adamgreig/supervide/panels/hardware.md

# Hardware shopping list
## Power end-plate
* 4 x M3x8 screws
* 4 x M3 full nuts

## Power mounting plates
* 7 x M3x10 screws
* 1 x M3x12 screws
* 8 x M3 full nuts

## Control end-plate
* 4 x M3x10 M-F pillars
* 4 x M3x6 screws
* 4 x M3 plain washers
* 4 x M3 full nuts
