adamgreig/supervide/power/bom.ods

Sheet: References
REF | FARNELL | DESC
C1 | 1759226 | 1nF 0805
C2 | 1759166 | 100nF 0805
C3 | 1759166 | 100nF 0805
C4 | 2057310 | 22nF 1210 HV
D1 | 2099239 | Green LED 0805
D2 | 2099243 | Yellow LED 0805
D3 | 2099236 | Red LED 0805
D4 | 1685055 | Orange LED 0805
F1 | 1162740 | 5x20mm clip
F2 | 1603990 | 1/2 BS1362 clip
K1 | 2325624 | RZ03-1A4
P1 | 2215303 | 2x4 conn
P2 | 2080426 | mains inlet
P3 | 2080465 | mains outlet
P4 | - | TP
P5 | - | TP
P6 | - | TP
Q1 | 1081223 | BC817-40
Q2 | 1081223 | BC817-40
R1 | 2331790 | 390R 0805
R2 | 2138881 | 300R 0805
R3 | 2138881 | 300R 0805
R4 | 2331790 | 390R 0805
R5 | 2138881 | 300R 0805
R6 | 2331790 | 390R 0805
R7 | 2138881 | 300R 0805
R8 | 1887414 | 47R 1206 HV
R9 | 2331787 | 300R 0805
U1 | 2401030 | VTX214
U2 | 1791411 | ACS710
U3 | SN36219 | Thermal switch
U4 | 1467853 | MOC3163-M
U5 | 1057281 | BTA16-800BRG
- | 1703170 | Heatsink
- | PL09982 | 13A BS1363
- | FF02750 | 100mA 5x20mm

Sheet: Parts
REFS | FARNELL | DESC | QUANTITY PER | Q FOR 3 BOARDS | SPARES | OWNED | TO ORDER
C1 | 1759226 | 1nF 0805 | 1 | 3 | 7 | 0 | 10
C2,C3 | 1759166 | 100nF 0805 | 2 | 6 | 4 | 0 | 10
C4 | 2057310 | 22nF 1210 HV | 1 | 3 | 2 | 0 | 5
D1 | 2099239 | Green LED 0805 | 1 | 3 | 1 | 0 | 4
D2 | 2099243 | Yellow LED 0805 | 1 | 3 | 1 | 0 | 4
D3 | 2099236 | Red LED 0805 | 1 | 3 | 1 | 0 | 4
D4 | 1685055 | Orange LED 0805 | 1 | 3 | 1 | 0 | 4
F1 | 1162740 | 5x20mm clip | 1 | 3 | 0 | 3 | 0
F2 | 1603990 | 1/2 BS1362 clip | 2 | 6 | 4 | 10 | 0
K1,K2 | 2325624 | RZ03-1A4 | 2 | 6 | 0 | 0 | 6
P1 | 2215303 | 2x4 conn | 1 | 3 | 0 | 0 | 3
P2 | 2080426 | mains inlet | 1 | 3 | 0 | 3 | 0
P3 | 2080465 | mains outlet | 1 | 3 | 0 | 3 | 0
Q1,Q2 | 1081223 | BC817-40 | 2 | 6 | 4 | 0 | 10
R1,R4,R6 | 2331790 | 390R 0805 | 3 | 9 | 11 | 0 | 20
R2,R3,R5,R7,R9 | 2138881 | 300R 0805 | 5 | 15 | 35 | 0 | 50
R8 | 1887414 | 47R 1206 HV | 1 | 3 | 22 | 0 | 25
U1 | 2401030 | VTX214 | 1 | 3 | 0 | 0 | 3
U2 | 1791411 | ACS710 | 1 | 3 | 0 | 0 | 3
U3 | SN36219 | Thermal switch | 1 | 3 | 0 | 0 | 3
U4 | 1467853 | MOC3163-M | 1 | 3 | 0 | 0 | 3
U5 | 1057281 | BTA16-800BRG | 1 | 3 | 1 | 4 | 0
- | 1703170 | Heatsink | 1 | 3 | 0 | 0 | 3
- | PL09982 | 13A BS1363 | 1 | 3 | 0 | 0 | 3
- | FF02750 | 100mA 5x20mm | 1 | 3 | 7 | 0 | 10

Sheet: Paste BOM
FARNELL | TO ORDER | REFS
1759226 | 10 | C1
1759166 | 10 | C2,C3
2057310 | 5 | C4
2099239 | 4 | D1
2099243 | 4 | D2
2099236 | 4 | D3
1685055 | 4 | D4
2325624 | 6 | K1,K2
2215303 | 3 | P1
1081223 | 10 | Q1,Q2
2331790 | 20 | R1,R4,R6
2138881 | 50 | R2,R3,R5,R7,R9
1887414 | 25 | R8
2401030 | 3 | U1
1791411 | 3 | U2
SN36219 | 3 | U3
1467853 | 3 | U4
1703170 | 3
PL09982 | 3
FF02750 | 10 | 100mA
Paste me into https://onecall.farnell.com/quick-order
