adamgreig/supervide/power/mounting hardware.ods

Screw name | Quantity | Size | PCB | Acrylic | TO220+sink+bush | Conn flange | Washers | Nuts | TOTAL LENGTH
- | - |  | 1.6 | 1.5 | 3.56 | 3 | 0.5 | 2.4
PCB mount | 2 | M3 | 1 | 2 |  |  | 2 | 1 | 8
TRIAC | 2 | M3 | 1 | 2 | 1 |  | 1 | 1 | 11.06
Conn PCB | 4 | M3 | 1 | 2 |  | 1 | 1 | 1 | 10.5
Conn back | 4 | M3 |  | 1 |  | 1 | 1 | 1 | 7.4
 |  | /board | /3 boards
M3 pan cheese screws |  | 12 | 36
M3 plain washers |  | 14 | 42
M3 full nuts |  | 12 | 36
