adamgreig/supervide/panels/power_mounting_plate.dxf

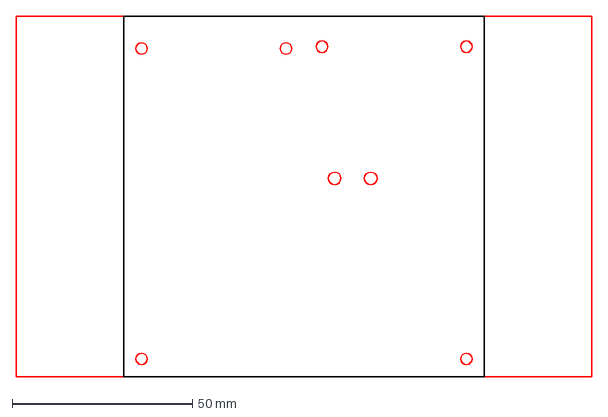
[picture p1: CAD file, 2016-04-06]
panels/power_mounting_plate.dxf
159.5 x 100.0 mm
