adamgreig/supervide/panels/power.dxf

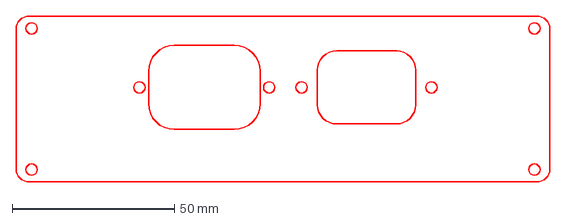
[picture p2: CAD file, 2016-04-06]
panels/power.dxf
164.5 x 51.1 mm
