adamgreig/supervide/panels/plate.dxf

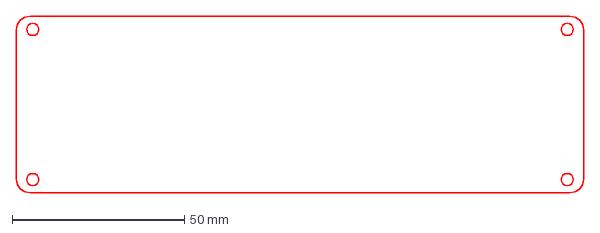
[picture p3: CAD file, 2016-04-06]
panels/plate.dxf
164.5 x 51.1 mm
