adamgreig/supervide/panels/control.dxf

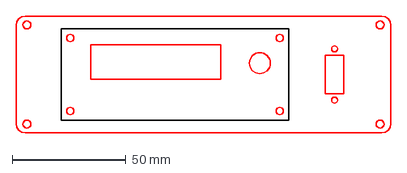
[picture p4: CAD file, 2016-04-06]
panels/control.dxf
164.5 x 51.1 mm
