adamgreig/supervide/panels/power_mounting_plate_small.dxf

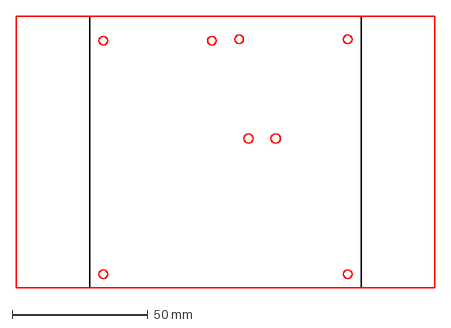
[picture p5: CAD file, 2016-04-05]
panels/power_mounting_plate_small.dxf
154.0 x 100.0 mm
