adamgreig/supervide/(threads)

Thread 1 (2015-04-28):

SOT23 pinout inverted

cillian64, 2015-04-28:
Transistors on both relays have their footprints inverted (as though the devices were upside-down).

Closed 2015-10-04.

Thread 2 (2015-04-28):

Temperature switch hole size too small

cillian64, 2015-04-28:
Holes on footprint for temperature cutoff switch (for heatsink) are too small for the wires with the specified temperature switches by a small amount.

Closed 2015-10-04.

Thread 3 (2015-04-28):

TRIAC pin clearance

cillian64, 2015-04-28:
TRIAC pins are awfully close for clearance/creep.  Maybe space them out if at all possible and maybe add slots.

Closed 2015-09-07.

Thread 7 (2015-04-28):

Control board resets

cillian64, 2015-04-28:
Reset every 100ms when wifi is connected and powered by internal LDO.  No resets when otherwise powered or when finger is applied to VCC or GND rail.  Maybe add separate 1A LDO for wifi module.

Closed 2015-10-07.

Thread 10 (2015-07-18):

Relay flyback diodes

cillian64, 2015-07-18:
Bodge flyback diodes onto the relays... :-(

Also add to proper PCB for r2?

cillian64, 2015-07-28:
Bodged on r1 hardware

Closed 2015-07-28.

Thread 11 (2015-07-26):

Add device-specifics to PWM/ADC drivers

cillian64, 2015-07-26:
The powerboard TRIAC and current-sense drivers were written for the generic ChibiOS HAL ADC and PWM drivers.  These probably need device-specific attributes adding to the config.  Once this is done they should be tested.

Closed 2015-10-24.

Thread 17 (2015-09-07):

Test rotary encoder interface

adamgreig, 2015-09-07:

adamgreig, 2015-10-07:
see 6e235f928a2a571786533eb94537d3c42cc7582b and ec04f92ea16fa8312bfe016d9e9c473816f2e737

cillian64, 2016-04-06:
Working in current master.

Closed 2016-04-06.

Thread 18 (2015-09-07):

Test buzzer

adamgreig, 2015-09-07:

adamgreig, 2015-10-04:
Dual channel DAC with DMA working but no sound. No output from opamp so suspect this might be a faulty opamp (it is missing a chunk of itself...) but should carefully check the opamp schematic design just in case there's a mistake.

Thread 20 (2015-09-07):

Test power control: relays and triac on/off (ignore pwm)

cillian64, 2015-09-07:

cillian64, 2015-10-24:
Resolved in dc6a1f4e

Closed 2015-10-24.

Thread 25 (2015-10-07):

pcb issues

cillian64, 2015-10-07:
- [x] make warning lightning bolt thicker
 - [x] make sure unmask is correct, esp near triac
 - [x] Check silky stuff is on the right layers
 - [x] fuse ratings on silk
 - [x] ground pour clearup
 - [ ] check relay drive circuits - SOT pinout, flyback diodes

Closed 2015-10-07.

Thread 26 (2015-10-20):

Power: R9 wrongnfarnell part

cillian64, 2015-10-20:
R9 should have same part number as the other 300R resistors but does not...

Closed 2015-11-01.

Thread 29 (2016-04-06):

End plates (control,power) are 0.5mm too long

cillian64, 2016-04-06:

Closed 2016-04-06.

Thread 31 (2016-04-06):

Large power mounting plate is 0.5mm too wide

cillian64, 2016-04-06:

Closed 2016-04-06.
