adamgreig/supervide/control/control.pdf

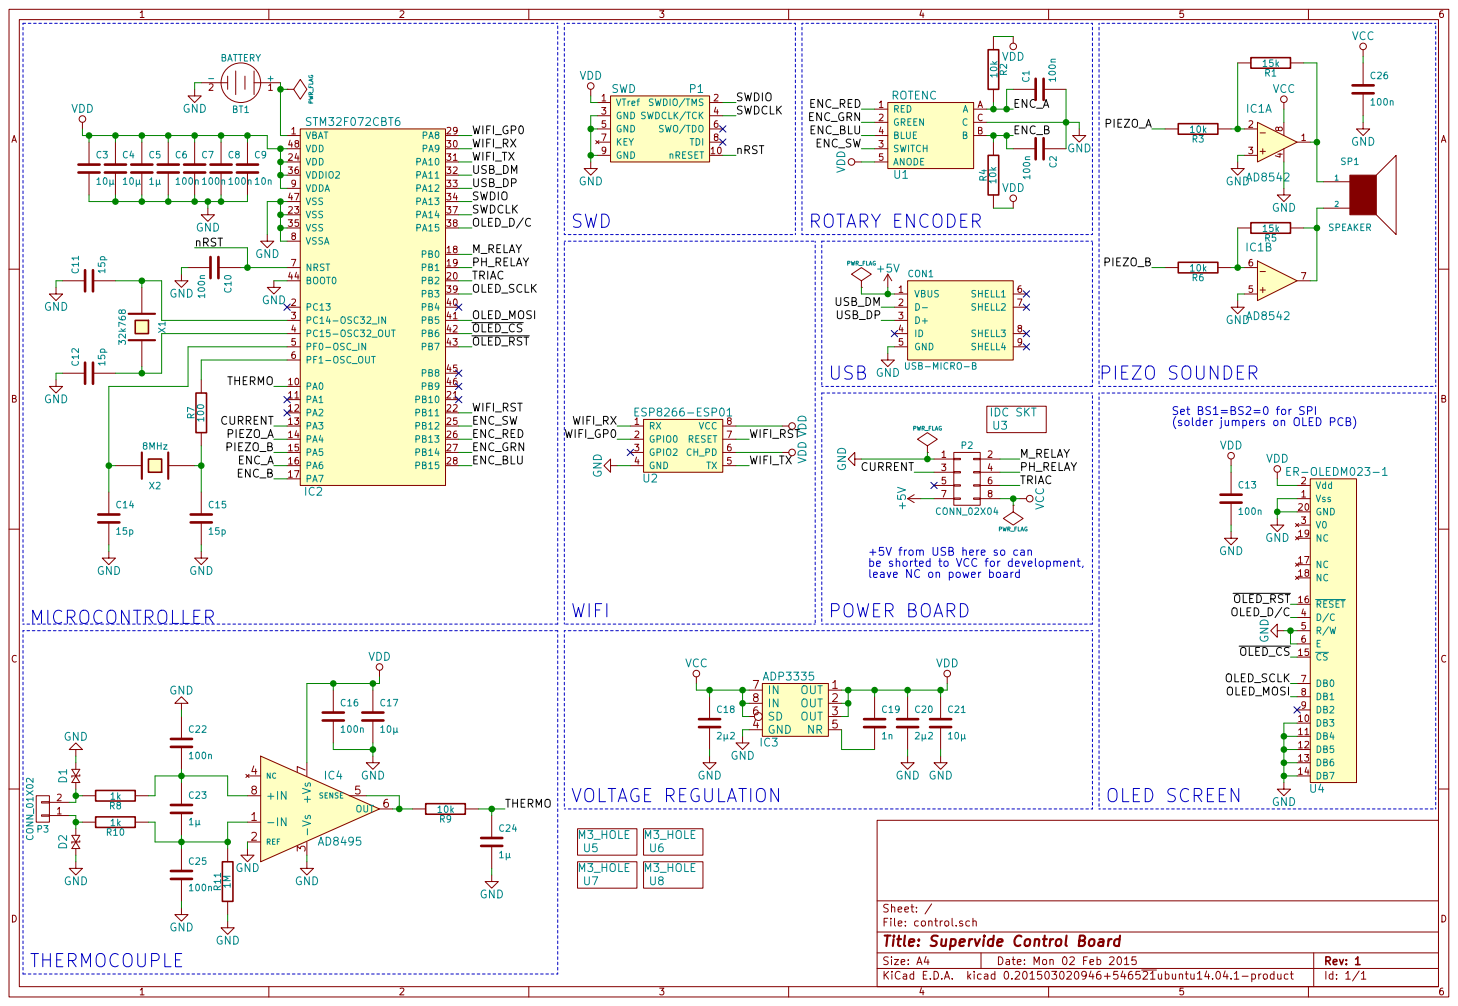
[picture p6: page 1]

leave NC on power board C3

USB

POWER BOARD | (solder jumpers on OLED PCB)

+5V from USB here so can
be shorted to VCC for development,

VDD | VCC

GND | | GND

File: control.sch Sheet: /
Id: 1/1 Title: Supervide Control Board
