adamgreig/supervide/control/control.kicad_pcb

## KiCad design control/control.kicad_pcb (2015-10-07)

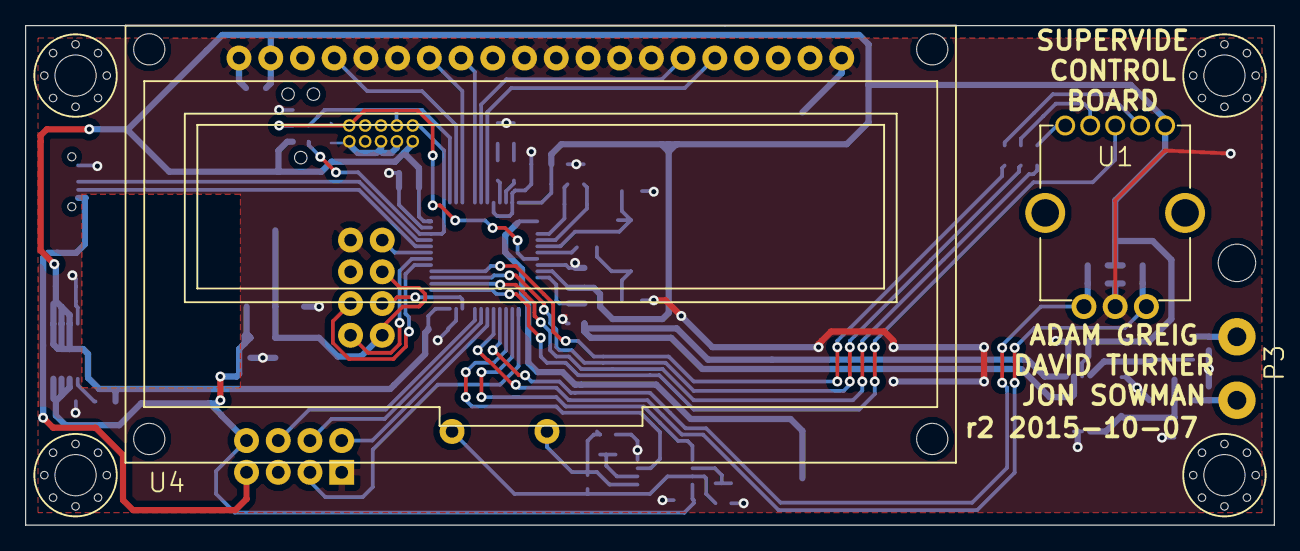
[picture p7: board control.kicad_pcb from above]

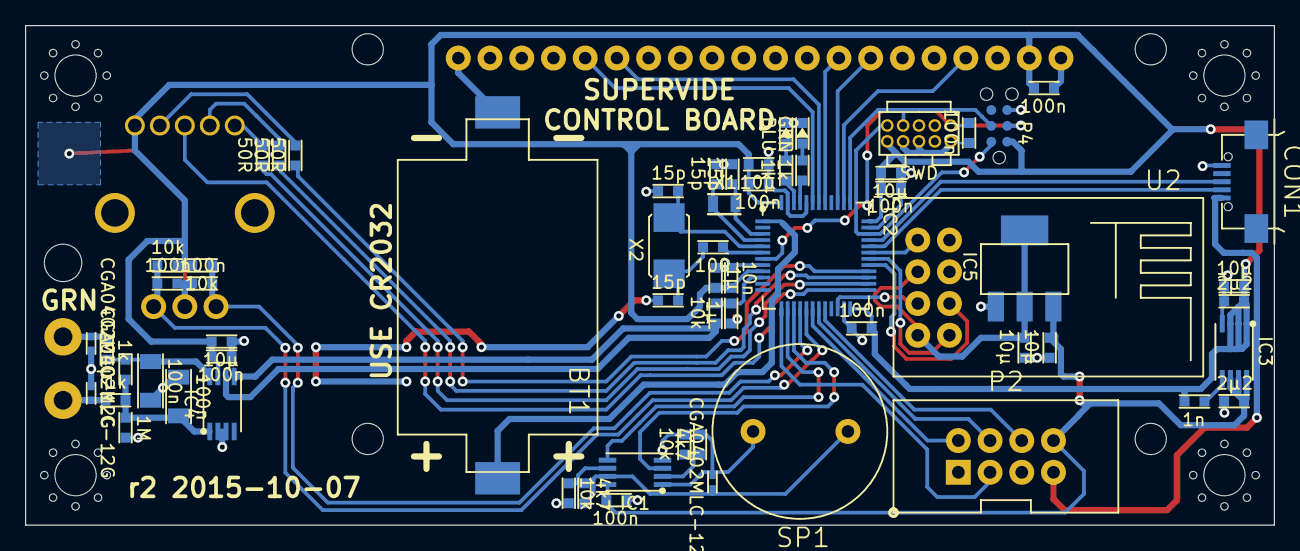
[picture p8: board control.kicad_pcb from below]

Board: 2 copper layers, 100.0 x 40.0 mm, 70 parts (63 on the bottom side), 55 nets.

Parts:
BT1: BATTERY; 2032HOLDER_KS1060
C1, C2, C6, C7, C8, C10, C13, C16, C26: 100n; C0603
C3, C4, C17, C21, C27, C28: 10µ; C0603
C5, C23, C24: 1µ; C0603
C9: 10n; C0603
C11, C12, C14, C15: 15p; C0603
C18, C20: 2µ2; C0603
C19: 1n; C0603
C22, C25: 100n; C1206
CON1: USB-MICRO-B; USB3065
D1, D2, D5: CGA0402MLC-12G; R0402
D3: GRN; LED0603
D4: BLU; LED0603
IC1: AD8542; MSOP8
IC2: STM32F072CBT6; LQFP48
IC3: ADP3335; MSOP8
IC4: AD8495; MSOP8
IC5: NCP1117; SOT223
P1: SWD; FTSH-105-01-F-D-K
P2: CONN_02X04; 2x4_100
P3: CONN_01X02; TC_K_PM
P4: CONN_02X03; TC2030-NL
R1, R5: 4k7; R0603
R2, R3, R4, R6, R9: 10k; R0603
R7: 100; R0603
R8, R10, R13, R14: 1k; R0603
R11: 1M; R0603
R12, R15, R16: 50R; R0603
SP1: SPEAKER; ABT-402-RC
U1: ROTENC; SF_ROTENC
U2: ESP8266-ESP01
U4: ER-OLEDM023-1
U5, U6, U7, U8: M3_HOLE; M3_MOUNT
X1: 32k768; R0805
X2: 8MHz; XTAL50x32

Connections:
+5V: CON1.1, P2.7
/CURRENT: IC2.13, P2.3
/ENC_A: C1.1, IC2.16, R2.2, U1.A
/ENC_B: C2.2, IC2.17, R4.2, U1.B
/ENC_BLU: IC2.28, R16.2
/ENC_GRN: IC2.27, R15.2
/ENC_RED: IC2.26, R12.2
/ENC_SW: IC2.25, U1.3
/M_RELAY: IC2.18, P2.2
/OLED_D/C: IC2.38, U4.4
/OLED_MOSI: IC2.41, U4.8
/OLED_SCLK: IC2.39, U4.7
/PH_RELAY: IC2.19, P2.4
/PIEZO_A: IC1.5, IC2.14
/PIEZO_B: IC1.3, IC2.15
/SWDCLK: IC2.37, P1.4, P4.4
/SWDIO: IC2.34, P1.2, P4.2
/THERMO: C24.1, IC2.10, R9.1
/TRIAC: IC2.20, P2.6
/USB_DM: CON1.2, IC2.32
/USB_DP: CON1.3, IC2.33
/WIFI_GP0: IC2.29, U2.2
/WIFI_RST: IC2.22, U2.7
/WIFI_RX: IC2.30, U2.1
/WIFI_TX: IC2.31, U2.5
/nRST: C10.1, IC2.7, P1.10, P4.3
/~OLED_CS: IC2.42, U4.15
/~OLED_RST: IC2.43, U4.16
GND: BT1.2, C1.2, C2.1, C3.2, C4.2, C5.2, C6.2, C7.2, C8.2, C9.2, C10.2, C11.1, C12.1, C13.2, C14.2, C15.2, C16.2, C17.2, C18.2, C20.2, C21.2, C22.1, C24.2, C25.2, C26.2, C27.2, C28.2, CON1.5, D1.1, D2.2, D3.1, D4.1, IC1.4, IC2.8, IC2.23, IC2.35, IC2.44, IC2.47, IC3.4, IC4.2, IC4.3, IC5.1, P1.3, P1.5, P1.9, P2.1, P4.5, R3.1, R6.1, R11.1, U1.C, U2.4, U4.1, U4.5, U4.6, U4.10, U4.11, U4.12, U4.13, U4.14, U4.20
unnamed: BT1.1, IC2.1
unnamed: C11.2, IC2.3, X1.1
unnamed: C12.2, IC2.4, X1.2
unnamed: C14.1, IC2.5, X2.2
unnamed: C15.1, R7.1, X2.1
unnamed: C19.2, IC3.5
unnamed: C22.2, C23.1, IC4.8, R8.1
unnamed: C23.2, C25.1, IC4.1, R10.1, R11.2
unnamed: C28.1, IC5.2, U2.6, U2.8
unnamed: D1.2, P3.2, R8.2
unnamed: D2.1, P3.1, R10.2
unnamed: D3.2, R13.1
unnamed: D4.2, R14.1
unnamed: D5.1, IC1.1, R1.1, SP1.1
unnamed: D5.2, IC1.7, R5.1, SP1.2
unnamed: IC1.2, R1.2, R3.2
unnamed: IC1.6, R5.2, R6.2
unnamed: IC2.6, R7.2
unnamed: IC2.45, R13.2
unnamed: IC2.46, R14.2
unnamed: IC4.5, IC4.6, R9.2
unnamed: R12.1, U1.1
unnamed: R15.1, U1.2
unnamed: R16.1, U1.4
VCC: C18.1, C26.1, C27.1, IC1.8, IC3.6, IC3.7, IC3.8, IC5.3, P2.8
VDD: C3.1, C4.1, C5.1, C6.1, C7.1, C8.1, C9.1, C13.1, C16.1, C17.1, C19.1, C20.1, C21.1, IC2.9, IC2.24, IC2.36, IC2.48, IC3.1, IC3.2, IC3.3, IC4.7, P1.1, P4.1, R2.1, R4.1, U1.5, U4.2
