adamgreig/supervide/power/power.kicad_pcb

## KiCad design power/power.kicad_pcb (2015-10-07)

Schematic: power.sch, Supervide Power Board

Parts:
C1: 1nF; C_0805; Farnell 1759226
C2, C3: 100nF; C_0805; Farnell 1759166
C4: 22nF; C_1210; Farnell 2057310
D1: POWER; LED-0805; Farnell 2099239
D2: MASTER; LED-0805; Farnell 2099243
D3: PREHEAT; LED-0805; Farnell 2099236
D4: TRIAC; LED-0805; Farnell 1685055
D5, D6: MBR2H200SFT1G; SOD-123FL; Farnell 2452032
F1: 100mA; 5x20_clip; Farnell 1162740
F2: 13A; BS1362_clip; Farnell 1603990
K1: MASTER_LIVE; RZ03-1A4; Farnell 2325624
K2: PREHEAT; RZ03-1A4; Farnell 2325624
P1: CONTROL; 2x4_100; Farnell 2215303
P2: MAINS_INLET; GSP1_9103_no_protrude; Farnell 2080426
P3: LOAD_OUTLET; 5001_no_protrude; Farnell 2080465
P4: +5V; 1pin
P5: GND; 1pin
P6: I_SENSE; 1pin
Q1, Q2: BC817-40; SOT23; Farnell 1081223
R1, R4, R6: 390R; R_0805; Farnell 2331790
R2, R3, R5, R7: 300R; R_0805; Farnell 2138881
R8: 47R; C_1206; Farnell 1887414
R9: 300R; C_0805; Farnell 2331787
U1: VTX214; Farnell 2401030
U2: ACS710; SOIC16W-chunky; Farnell 1791411
U3: 70°C; WireConnection_1mmDrill; Farnell SN36219
U4: MOC3163-M; DIP-6__300_ELL; Farnell 1467853
U5: BTA16-800BRG; TO-220_Neutral123_Vertical_LargePads; Farnell 1057281

Connections:
+5V: C3.1, D1.1 (A), D2.1 (A), D3.1 (A), D5.1, D6.1, K1.2, K2.2, P1.8, P4.1, U1.3, U2.14; also elsewhere on the board
/EARTH: P2.1, P3.1
GND: C1.2, C2.2, C3.2, D4.2 (K), P1.1, P5.1, Q1.2, Q2.2, R3.2, R9.2, U1.4, U2.9, U2.16
I_SENSE: P1.3, P6.1, U2.12
LOAD_LIVE: K2.4, P3.3, R8.2, U5.1
LOAD_NEUTRAL: P3.2, U2.1, U2.2, U2.3, U2.4
MAINS_LIVE: F1.1, F2.2, K1.3
MAINS_NEUTRAL: P2.2, U1.2, U2.5, U2.6, U2.7, U2.8
MASTER_RELAY: P1.2, R1.2
unnamed: C1.1, U2.10
unnamed: C2.1, U2.11
unnamed: C4.2, R8.1
unnamed 12: D1.2 (K), R3.1; also elsewhere on the board
unnamed: D2.2 (K), R2.2
unnamed: D3.2 (K), R5.2
unnamed: D4.1 (A), R7.2
unnamed: D5.2, K1.1, Q1.3, R2.1
unnamed: D6.2, K2.1, Q2.3, R5.1
unnamed: F1.2, U1.1
unnamed: F2.1, P2.3
unnamed: Q1.1, R1.1
unnamed: Q2.1, R4.1
unnamed: R6.1, U3.1
unnamed: R6.2, U4.6 (S1)
unnamed: R9.1, U4.2 (K)
unnamed: U4.4 (S2), U5.3
PREHEAT_RELAY: P1.4, R4.2
TRIAC_MAINS: C4.1, K1.4, K2.3, U3.2, U5.2
TRIAC_TRIG: P1.6, R7.1, U4.1 (A)

Notes on the sheet:
LOAD CONTROL
POWER SUPPLY
CURRENT SENSE
CONNECTORS
56mV/A version: ACS710KLATR-12CB-T
Sets bandwidth with internal filter R
MAGIC BOX
5V 3W VTX-214-003-105
1000V/us min critical rise 5mA trigger current 12V typical inhibit voltage DIP-6
ORANGE
GREEN
RED
YELLOW
Heatsink: 1703170
ISOLATED TAB

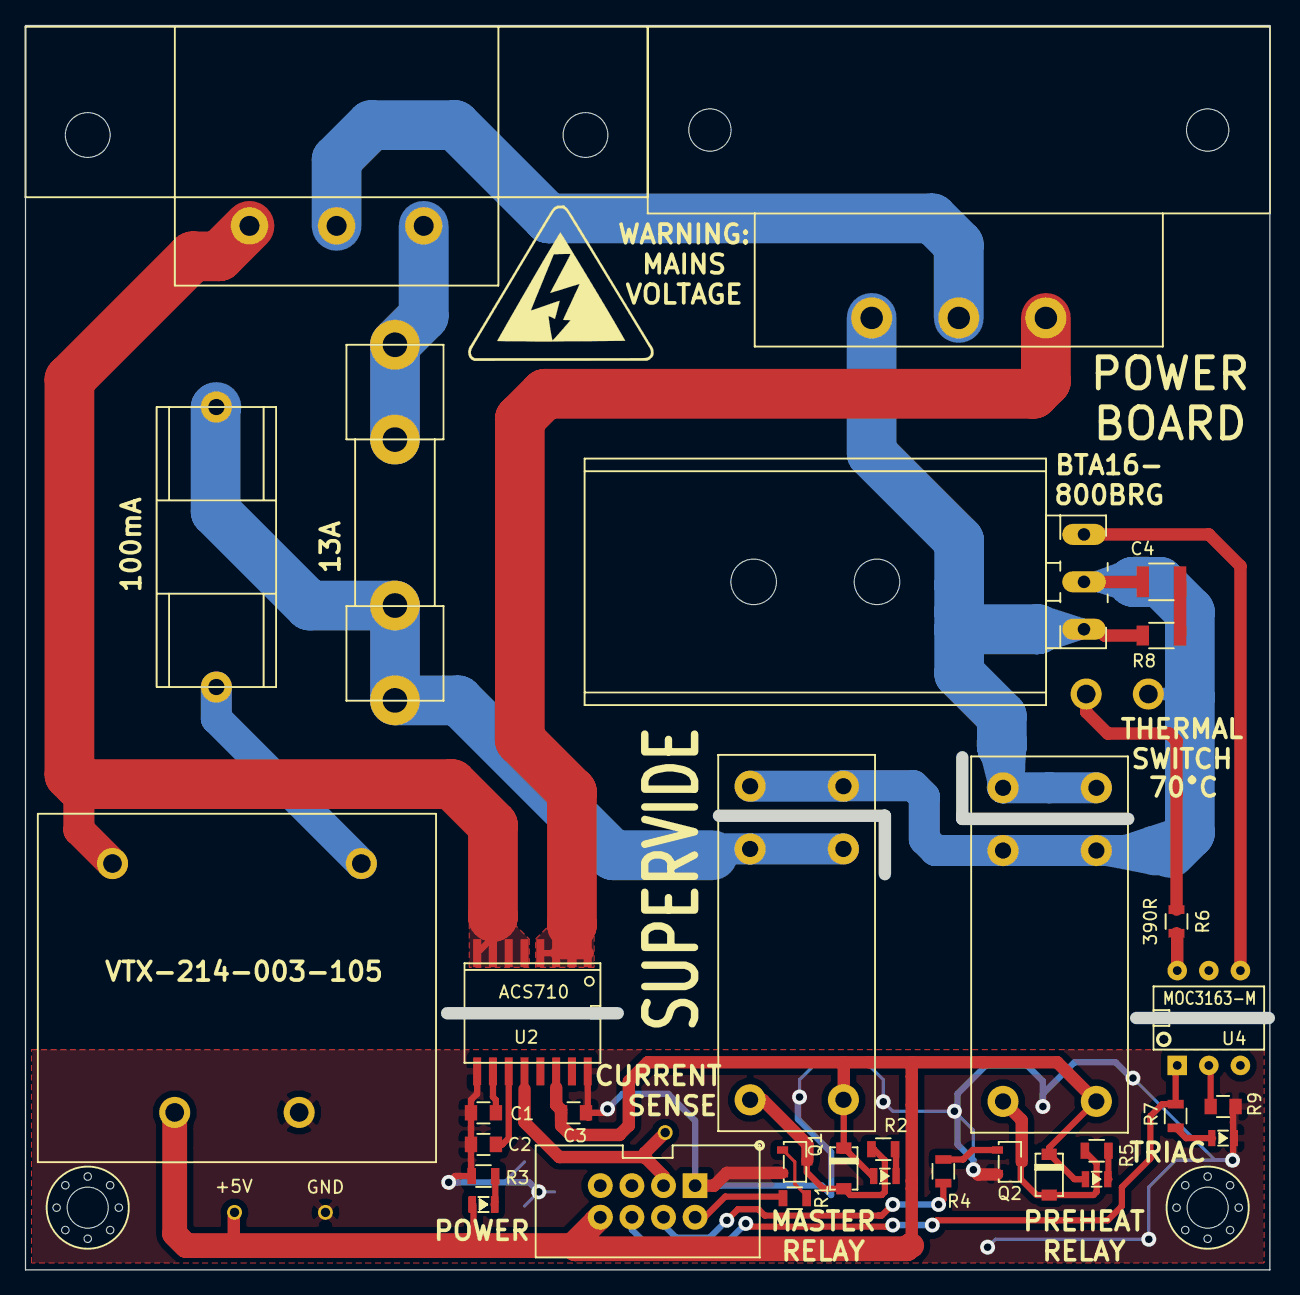
[picture p9: board power.kicad_pcb from above]

Board: 2 copper layers, 100.0 x 100.0 mm, 39 parts (0 on the bottom side), 29 nets.

Other parts of the board:
D1#2: POWER; LED-0805
M3_MOUNT, M3_MOUNT#2: VAL**; M3_MOUNT

Their connections:
+5V: D1#2.1; also elsewhere on the board
unnamed 12: D1#2.2; also elsewhere on the board
