adamgreig/supervide/firmware/chibi/board.h

/*
    ChibiOS - Copyright (C) 2006..2015 Giovanni Di Sirio

    Licensed under the Apache License, Version 2.0 (the "License");
    you may not use this file except in compliance with the License.
    You may obtain a copy of the License at

        http://www.apache.org/licenses/LICENSE-2.0

    Unless required by applicable law or agreed to in writing, software
    distributed under the License is distributed on an "AS IS" BASIS,
    WITHOUT WARRANTIES OR CONDITIONS OF ANY KIND, either express or implied.
    See the License for the specific language governing permissions and
    limitations under the License.
*/

#ifndef _BOARD_H_
#define _BOARD_H_

/*
 * Setup for Supervide r1 board
 */

/*
 * Board identifier.
 */
#define BOARD_ST_STM32F072B_DISCOVERY
#define BOARD_NAME                  "Supervide"

/*
 * Board oscillators-related settings.
 * NOTE: LSE not fitted.
 * NOTE: HSE not fitted.
 */
#if !defined(STM32_LSECLK)
#define STM32_LSECLK                32768U
#endif

#define STM32_LSEDRV                (3U << 3U)

#if !defined(STM32_HSECLK)
#define STM32_HSECLK                8000000U
#endif

/*
 * MCU type as defined in the ST header.
 */
#define STM32F072xB

/*
 * IO pins assignments.
 */
#define GPIOA_THERMO                0U
#define GPIOA_NC1                   1U
#define GPIOA_NC2                   2U
#define GPIOA_CURRENT               3U
#define GPIOA_PIEZO_A               4U
#define GPIOA_PIEZO_B               5U
#define GPIOA_ENC_A                 6U
#define GPIOA_ENC_B                 7U
#define GPIOA_WIFI_GP0              8U
#define GPIOA_WIFI_RX               9U
#define GPIOA_WIFI_TX               10U
#define GPIOA_USB_DM                11U
#define GPIOA_USB_DP                12U
#define GPIOA_SWDIO                 13U
#define GPIOA_SWCLK                 14U
#define GPIOA_OLED_DC               15U

#define GPIOB_RELAY_M               0U
#define GPIOB_RELAY_PH              1U
#define GPIOB_TRIAC                 2U
#define GPIOB_OLED_SCLK             3U
#define GPIOB_NC4                   4U
#define GPIOB_OLED_MOSI             5U
#define GPIOB_OLED_CS               6U
#define GPIOB_OLED_RST              7U
#define GPIOB_NC8                   8U
#define GPIOB_NC9                   9U
#define GPIOB_NC10                  10U
#define GPIOB_WIFI_RST              11U
#define GPIOB_ENC_SW                12U
#define GPIOB_ENC_RED               13U
#define GPIOB_ENC_GRN               14U
#define GPIOB_ENC_BLU               15U

#define GPIOC_PIN0                  0U
#define GPIOC_PIN1                  1U
#define GPIOC_PIN2                  2U
#define GPIOC_PIN3                  3U
#define GPIOC_PIN4                  4U
#define GPIOC_PIN5                  5U
#define GPIOC_PIN6                  6U
#define GPIOC_PIN7                  7U
#define GPIOC_PIN8                  8U
#define GPIOC_PIN9                  9U
#define GPIOC_PIN10                 10U
#define GPIOC_PIN11                 11U
#define GPIOC_PIN12                 12U
#define GPIOC_PIN13                 13U
#define GPIOC_OSC32_IN              14U
#define GPIOC_OSC32_OUT             15U

#define GPIOD_PIN0                  0U
#define GPIOD_PIN1                  1U
#define GPIOD_PIN2                  2U
#define GPIOD_PIN3                  3U
#define GPIOD_PIN4                  4U
#define GPIOD_PIN5                  5U
#define GPIOD_PIN6                  6U
#define GPIOD_PIN7                  7U
#define GPIOD_PIN8                  8U
#define GPIOD_PIN9                  9U
#define GPIOD_PIN10                 10U
#define GPIOD_PIN11                 11U
#define GPIOD_PIN12                 12U
#define GPIOD_PIN13                 13U
#define GPIOD_PIN14                 14U
#define GPIOD_PIN15                 15U

#define GPIOE_PIN0                  0U
#define GPIOE_PIN1                  1U
#define GPIOE_PIN2                  2U
#define GPIOE_PIN3                  3U
#define GPIOE_PIN4                  4U
#define GPIOE_PIN5                  5U
#define GPIOE_PIN6                  6U
#define GPIOE_PIN7                  7U
#define GPIOE_PIN8                  8U
#define GPIOE_PIN9                  9U
#define GPIOE_PIN10                 10U
#define GPIOE_PIN11                 11U
#define GPIOE_PIN12                 12U
#define GPIOE_PIN13                 13U
#define GPIOE_PIN14                 14U
#define GPIOE_PIN15                 15U

#define GPIOF_OSC_IN                0U
#define GPIOF_OSC_OUT               1U
#define GPIOF_PIN2                  2U
#define GPIOF_PIN3                  3U
#define GPIOF_PIN4                  4U
#define GPIOF_PIN5                  5U
#define GPIOF_PIN6                  6U
#define GPIOF_PIN7                  7U
#define GPIOF_PIN8                  8U
#define GPIOF_PIN9                  9U
#define GPIOF_PIN10                 10U
#define GPIOF_PIN11                 11U
#define GPIOF_PIN12                 12U
#define GPIOF_PIN13                 13U
#define GPIOF_PIN14                 14U
#define GPIOF_PIN15                 15U

/*
 * I/O ports initial setup, this configuration is established soon after reset
 * in the initialization code.
 * Please refer to the STM32 Reference Manual for details.
 */
#define PIN_MODE_INPUT(n)           (0U << ((n) * 2U))
#define PIN_MODE_OUTPUT(n)          (1U << ((n) * 2U))
#define PIN_MODE_ALTERNATE(n)       (2U << ((n) * 2U))
#define PIN_MODE_ANALOG(n)          (3U << ((n) * 2U))
#define PIN_ODR_LOW(n)              (0U << (n))
#define PIN_ODR_HIGH(n)             (1U << (n))
#define PIN_OTYPE_PUSHPULL(n)       (0U << (n))
#define PIN_OTYPE_OPENDRAIN(n)      (1U << (n))
#define PIN_OSPEED_2M(n)            (0U << ((n) * 2U))
#define PIN_OSPEED_10M(n)           (1U << ((n) * 2U))
#define PIN_OSPEED_40M(n)           (3U << ((n) * 2U))
#define PIN_PUPDR_FLOATING(n)       (0U << ((n) * 2U))
#define PIN_PUPDR_PULLUP(n)         (1U << ((n) * 2U))
#define PIN_PUPDR_PULLDOWN(n)       (2U << ((n) * 2U))
#define PIN_AFIO_AF(n, v)           ((v##U) << (((n) % 8U) * 4U))

/*
 * GPIOA setup
 */
#define VAL_GPIOA_MODER             (PIN_MODE_ANALOG(GPIOA_THERMO) |        \
                                     PIN_MODE_INPUT(GPIOA_NC1) |            \
                                     PIN_MODE_INPUT(GPIOA_NC2) |            \
                                     PIN_MODE_ANALOG(GPIOA_CURRENT) |       \
                                     PIN_MODE_ANALOG(GPIOA_PIEZO_A) |       \
                                     PIN_MODE_ANALOG(GPIOA_PIEZO_B) |       \
                                     PIN_MODE_ALTERNATE(GPIOA_ENC_A) |      \
                                     PIN_MODE_ALTERNATE(GPIOA_ENC_B) |      \
                                     PIN_MODE_OUTPUT(GPIOA_WIFI_GP0) |      \
                                     PIN_MODE_ALTERNATE(GPIOA_WIFI_RX) |    \
                                     PIN_MODE_ALTERNATE(GPIOA_WIFI_TX) |    \
                                     PIN_MODE_INPUT(GPIOA_USB_DM) |         \
                                     PIN_MODE_INPUT(GPIOA_USB_DP) |         \
                                     PIN_MODE_ALTERNATE(GPIOA_SWDIO) |      \
                                     PIN_MODE_ALTERNATE(GPIOA_SWCLK) |      \
                                     PIN_MODE_OUTPUT(GPIOA_OLED_DC))
#define VAL_GPIOA_OTYPER            (PIN_OTYPE_PUSHPULL(GPIOA_THERMO) |     \
                                     PIN_OTYPE_PUSHPULL(GPIOA_NC1) |        \
                                     PIN_OTYPE_PUSHPULL(GPIOA_NC2) |        \
                                     PIN_OTYPE_PUSHPULL(GPIOA_CURRENT) |    \
                                     PIN_OTYPE_PUSHPULL(GPIOA_PIEZO_A) |    \
                                     PIN_OTYPE_PUSHPULL(GPIOA_PIEZO_B) |    \
                                     PIN_OTYPE_PUSHPULL(GPIOA_ENC_A) |      \
                                     PIN_OTYPE_PUSHPULL(GPIOA_ENC_B) |      \
                                     PIN_OTYPE_PUSHPULL(GPIOA_WIFI_GP0) |   \
                                     PIN_OTYPE_PUSHPULL(GPIOA_WIFI_RX) |    \
                                     PIN_OTYPE_PUSHPULL(GPIOA_WIFI_TX) |    \
                                     PIN_OTYPE_PUSHPULL(GPIOA_USB_DM) |     \
                                     PIN_OTYPE_PUSHPULL(GPIOA_USB_DP) |     \
                                     PIN_OTYPE_PUSHPULL(GPIOA_SWDIO) |      \
                                     PIN_OTYPE_PUSHPULL(GPIOA_SWCLK) |      \
                                     PIN_OTYPE_PUSHPULL(GPIOA_OLED_DC))
#define VAL_GPIOA_OSPEEDR           (PIN_OSPEED_2M(GPIOA_THERMO) |          \
                                     PIN_OSPEED_2M(GPIOA_NC1) |             \
                                     PIN_OSPEED_2M(GPIOA_NC2) |             \
                                     PIN_OSPEED_2M(GPIOA_CURRENT) |         \
                                     PIN_OSPEED_2M(GPIOA_PIEZO_A) |         \
                                     PIN_OSPEED_2M(GPIOA_PIEZO_B) |         \
                                     PIN_OSPEED_2M(GPIOA_ENC_A) |           \
                                     PIN_OSPEED_2M(GPIOA_ENC_B) |           \
                                     PIN_OSPEED_2M(GPIOA_WIFI_GP0) |        \
                                     PIN_OSPEED_40M(GPIOA_WIFI_RX) |        \
                                     PIN_OSPEED_40M(GPIOA_WIFI_TX) |        \
                                     PIN_OSPEED_40M(GPIOA_USB_DM) |         \
                                     PIN_OSPEED_40M(GPIOA_USB_DP) |         \
                                     PIN_OSPEED_40M(GPIOA_SWDIO) |          \
                                     PIN_OSPEED_40M(GPIOA_SWCLK) |          \
                                     PIN_OSPEED_2M(GPIOA_OLED_DC))
#define VAL_GPIOA_PUPDR             (PIN_PUPDR_FLOATING(GPIOA_THERMO) |     \
                                     PIN_PUPDR_PULLUP(GPIOA_NC1) |          \
                                     PIN_PUPDR_PULLUP(GPIOA_NC2) |          \
                                     PIN_PUPDR_FLOATING(GPIOA_CURRENT) |    \
                                     PIN_PUPDR_FLOATING(GPIOA_PIEZO_A) |      \
                                     PIN_PUPDR_FLOATING(GPIOA_PIEZO_B) |      \
                                     PIN_PUPDR_PULLUP(GPIOA_ENC_A) |        \
                                     PIN_PUPDR_PULLUP(GPIOA_ENC_B) |        \
                                     PIN_PUPDR_PULLUP(GPIOA_WIFI_GP0) |     \
                                     PIN_PUPDR_PULLUP(GPIOA_WIFI_RX) |      \
                                     PIN_PUPDR_PULLUP(GPIOA_WIFI_TX) |      \
                                     PIN_PUPDR_FLOATING(GPIOA_USB_DM) |     \
                                     PIN_PUPDR_FLOATING(GPIOA_USB_DP) |     \
                                     PIN_PUPDR_PULLUP(GPIOA_SWDIO) |        \
                                     PIN_PUPDR_PULLDOWN(GPIOA_SWCLK) |      \
                                     PIN_PUPDR_PULLUP(GPIOA_OLED_DC))
#define VAL_GPIOA_ODR               (PIN_ODR_HIGH(GPIOA_THERMO) |           \
                                     PIN_ODR_HIGH(GPIOA_NC1) |              \
                                     PIN_ODR_HIGH(GPIOA_NC2) |              \
                                     PIN_ODR_HIGH(GPIOA_CURRENT) |          \
                                     PIN_ODR_LOW(GPIOA_PIEZO_A) |           \
                                     PIN_ODR_LOW(GPIOA_PIEZO_B) |           \
                                     PIN_ODR_HIGH(GPIOA_ENC_A) |            \
                                     PIN_ODR_HIGH(GPIOA_ENC_B) |            \
                                     PIN_ODR_HIGH(GPIOA_WIFI_GP0) |         \
                                     PIN_ODR_HIGH(GPIOA_WIFI_RX) |          \
                                     PIN_ODR_HIGH(GPIOA_WIFI_TX) |          \
                                     PIN_ODR_HIGH(GPIOA_USB_DM) |           \
                                     PIN_ODR_HIGH(GPIOA_USB_DP) |           \
                                     PIN_ODR_HIGH(GPIOA_SWDIO) |            \
                                     PIN_ODR_HIGH(GPIOA_SWCLK) |            \
                                     PIN_ODR_HIGH(GPIOA_OLED_DC))
#define VAL_GPIOA_AFRL              (PIN_AFIO_AF(GPIOA_THERMO, 0) |         \
                                     PIN_AFIO_AF(GPIOA_NC1, 0) |            \
                                     PIN_AFIO_AF(GPIOA_NC2, 0) |            \
                                     PIN_AFIO_AF(GPIOA_CURRENT, 0) |        \
                                     PIN_AFIO_AF(GPIOA_PIEZO_A, 0) |        \
                                     PIN_AFIO_AF(GPIOA_PIEZO_B, 0) |        \
                                     PIN_AFIO_AF(GPIOA_ENC_A, 1) |          \
                                     PIN_AFIO_AF(GPIOA_ENC_B, 1))
#define VAL_GPIOA_AFRH              (PIN_AFIO_AF(GPIOA_WIFI_GP0, 0) |       \
                                     PIN_AFIO_AF(GPIOA_WIFI_RX, 1) |        \
                                     PIN_AFIO_AF(GPIOA_WIFI_TX, 1) |        \
                                     PIN_AFIO_AF(GPIOA_USB_DM, 0) |         \
                                     PIN_AFIO_AF(GPIOA_USB_DP, 0) |         \
                                     PIN_AFIO_AF(GPIOA_SWDIO, 0) |          \
                                     PIN_AFIO_AF(GPIOA_SWCLK, 0) |          \
                                     PIN_AFIO_AF(GPIOA_OLED_DC, 0))

/*
 * GPIOB setup:
 */
#define VAL_GPIOB_MODER             (PIN_MODE_OUTPUT(GPIOB_RELAY_M) |       \
                                     PIN_MODE_OUTPUT(GPIOB_RELAY_PH) |      \
                                     PIN_MODE_OUTPUT(GPIOB_TRIAC) |         \
                                     PIN_MODE_ALTERNATE(GPIOB_OLED_SCLK) |  \
                                     PIN_MODE_INPUT(GPIOB_NC4) |            \
                                     PIN_MODE_ALTERNATE(GPIOB_OLED_MOSI) |  \
                                     PIN_MODE_OUTPUT(GPIOB_OLED_CS) |       \
                                     PIN_MODE_OUTPUT(GPIOB_OLED_RST) |      \
                                     PIN_MODE_INPUT(GPIOB_NC8) |            \
                                     PIN_MODE_INPUT(GPIOB_NC9) |            \
                                     PIN_MODE_INPUT(GPIOB_NC10) |           \
                                     PIN_MODE_OUTPUT(GPIOB_WIFI_RST) |      \
                                     PIN_MODE_INPUT(GPIOB_ENC_SW) |         \
                                     PIN_MODE_OUTPUT(GPIOB_ENC_RED) |    \
                                     PIN_MODE_OUTPUT(GPIOB_ENC_GRN) |    \
                                     PIN_MODE_OUTPUT(GPIOB_ENC_BLU))
#define VAL_GPIOB_OTYPER            (PIN_OTYPE_PUSHPULL(GPIOB_RELAY_M) |    \
                                     PIN_OTYPE_PUSHPULL(GPIOB_RELAY_PH) |   \
                                     PIN_OTYPE_PUSHPULL(GPIOB_TRIAC) |      \
                                     PIN_OTYPE_PUSHPULL(GPIOB_OLED_SCLK) |  \
                                     PIN_OTYPE_PUSHPULL(GPIOB_NC4) |        \
                                     PIN_OTYPE_PUSHPULL(GPIOB_OLED_MOSI) |  \
                                     PIN_OTYPE_PUSHPULL(GPIOB_OLED_CS) |    \
                                     PIN_OTYPE_PUSHPULL(GPIOB_OLED_RST) |   \
                                     PIN_OTYPE_PUSHPULL(GPIOB_NC8) |        \
                                     PIN_OTYPE_PUSHPULL(GPIOB_NC9) |        \
                                     PIN_OTYPE_PUSHPULL(GPIOB_NC10) |       \
                                     PIN_OTYPE_PUSHPULL(GPIOB_WIFI_RST) |   \
                                     PIN_OTYPE_PUSHPULL(GPIOB_ENC_SW) |     \
                                     PIN_OTYPE_PUSHPULL(GPIOB_ENC_RED) |    \
                                     PIN_OTYPE_PUSHPULL(GPIOB_ENC_GRN) |    \
                                     PIN_OTYPE_PUSHPULL(GPIOB_ENC_BLU))
#define VAL_GPIOB_OSPEEDR           (PIN_OSPEED_2M(GPIOB_RELAY_M) |         \
                                     PIN_OSPEED_2M(GPIOB_RELAY_PH) |        \
                                     PIN_OSPEED_2M(GPIOB_TRIAC) |           \
                                     PIN_OSPEED_40M(GPIOB_OLED_SCLK) |      \
                                     PIN_OSPEED_2M(GPIOB_NC4) |             \
                                     PIN_OSPEED_40M(GPIOB_OLED_MOSI) |      \
                                     PIN_OSPEED_40M(GPIOB_OLED_CS) |        \
                                     PIN_OSPEED_40M(GPIOB_OLED_RST) |       \
                                     PIN_OSPEED_2M(GPIOB_NC8) |             \
                                     PIN_OSPEED_2M(GPIOB_NC9) |             \
                                     PIN_OSPEED_2M(GPIOB_NC10) |            \
                                     PIN_OSPEED_2M(GPIOB_WIFI_RST) |        \
                                     PIN_OSPEED_2M(GPIOB_ENC_SW) |          \
                                     PIN_OSPEED_2M(GPIOB_ENC_RED) |         \
                                     PIN_OSPEED_2M(GPIOB_ENC_GRN) |         \
                                     PIN_OSPEED_2M(GPIOB_ENC_BLU))
#define VAL_GPIOB_PUPDR             (PIN_PUPDR_PULLDOWN(GPIOB_RELAY_M) |    \
                                     PIN_PUPDR_PULLDOWN(GPIOB_RELAY_PH) |   \
                                     PIN_PUPDR_PULLDOWN(GPIOB_TRIAC) |      \
                                     PIN_PUPDR_PULLUP(GPIOB_OLED_SCLK) |    \
                                     PIN_PUPDR_PULLUP(GPIOB_NC4) |          \
                                     PIN_PUPDR_PULLUP(GPIOB_OLED_MOSI) |    \
                                     PIN_PUPDR_PULLUP(GPIOB_OLED_CS) |      \
                                     PIN_PUPDR_PULLUP(GPIOB_OLED_RST) |     \
                                     PIN_PUPDR_PULLUP(GPIOB_NC8) |          \
                                     PIN_PUPDR_PULLUP(GPIOB_NC9) |          \
                                     PIN_PUPDR_PULLUP(GPIOB_NC10) |         \
                                     PIN_PUPDR_PULLUP(GPIOB_WIFI_RST) |     \
                                     PIN_PUPDR_PULLDOWN(GPIOB_ENC_SW) |     \
                                     PIN_PUPDR_PULLUP(GPIOB_ENC_RED) |      \
                                     PIN_PUPDR_PULLUP(GPIOB_ENC_GRN) |      \
                                     PIN_PUPDR_PULLUP(GPIOB_ENC_BLU))
#define VAL_GPIOB_ODR               (PIN_ODR_LOW(GPIOB_RELAY_M) |           \
                                     PIN_ODR_LOW(GPIOB_RELAY_PH) |          \
                                     PIN_ODR_LOW(GPIOB_TRIAC) |             \
                                     PIN_ODR_HIGH(GPIOB_OLED_SCLK) |        \
                                     PIN_ODR_HIGH(GPIOB_NC4) |              \
                                     PIN_ODR_HIGH(GPIOB_OLED_MOSI) |        \
                                     PIN_ODR_HIGH(GPIOB_OLED_CS) |          \
                                     PIN_ODR_HIGH(GPIOB_OLED_RST) |         \
                                     PIN_ODR_HIGH(GPIOB_NC8) |              \
                                     PIN_ODR_HIGH(GPIOB_NC9) |              \
                                     PIN_ODR_HIGH(GPIOB_NC10) |             \
                                     PIN_ODR_HIGH(GPIOB_WIFI_RST) |         \
                                     PIN_ODR_HIGH(GPIOB_ENC_SW) |           \
                                     PIN_ODR_HIGH(GPIOB_ENC_RED) |          \
                                     PIN_ODR_HIGH(GPIOB_ENC_GRN) |          \
                                     PIN_ODR_HIGH(GPIOB_ENC_BLU))
#define VAL_GPIOB_AFRL              (PIN_AFIO_AF(GPIOB_RELAY_M, 0) |        \
                                     PIN_AFIO_AF(GPIOB_RELAY_PH, 0) |       \
                                     PIN_AFIO_AF(GPIOB_TRIAC, 0) |          \
                                     PIN_AFIO_AF(GPIOB_OLED_SCLK, 0) |      \
                                     PIN_AFIO_AF(GPIOB_NC4, 0) |            \
                                     PIN_AFIO_AF(GPIOB_OLED_MOSI, 0) |      \
                                     PIN_AFIO_AF(GPIOB_OLED_CS, 0) |        \
                                     PIN_AFIO_AF(GPIOB_OLED_RST, 0))
#define VAL_GPIOB_AFRH              (PIN_AFIO_AF(GPIOB_NC8, 0) |            \
                                     PIN_AFIO_AF(GPIOB_NC9, 0) |            \
                                     PIN_AFIO_AF(GPIOB_NC10, 0) |           \
                                     PIN_AFIO_AF(GPIOB_WIFI_RST, 0) |       \
                                     PIN_AFIO_AF(GPIOB_ENC_SW, 0) |         \
                                     PIN_AFIO_AF(GPIOB_ENC_RED, 2) |        \
                                     PIN_AFIO_AF(GPIOB_ENC_GRN, 2) |        \
                                     PIN_AFIO_AF(GPIOB_ENC_BLU, 2))

/*
 * GPIOC setup:
 *
 * PC0  - PIN0                   (output pushpull maximum).
 * PC1  - PIN1                      (input pullup).
 * PC2  - PIN2                      (input pullup).
 * PC3  - PIN3                      (input pullup).
 * PC4  - PIN4                      (input pullup).
 * PC5  - PIN5                      (input pullup).
 * PC6  - LED_RED                   (output pushpull maximum).
 * PC7  - LED_BLUE                  (output pushpull maximum).
 * PC8  - LED_ORANGE                (output pushpull maximum).
 * PC9  - LED_GREEN                 (output pushpull maximum).
 * PC10 - PIN10                     (input pullup).
 * PC11 - PIN11                     (input pullup).
 * PC12 - PIN12                     (input pullup).
 * PC13 - PIN13                     (input pullup).
 * PC14 - OSC32_IN                  (input floating).
 * PC15 - OSC32_OUT                 (input floating).
 */
#define VAL_GPIOC_MODER             (PIN_MODE_INPUT(GPIOC_PIN0) |           \
                                     PIN_MODE_INPUT(GPIOC_PIN1) |           \
                                     PIN_MODE_INPUT(GPIOC_PIN2) |           \
                                     PIN_MODE_INPUT(GPIOC_PIN3) |           \
                                     PIN_MODE_INPUT(GPIOC_PIN4) |           \
                                     PIN_MODE_INPUT(GPIOC_PIN5) |           \
                                     PIN_MODE_INPUT(GPIOC_PIN6) |           \
                                     PIN_MODE_INPUT(GPIOC_PIN7) |           \
                                     PIN_MODE_INPUT(GPIOC_PIN8) |           \
                                     PIN_MODE_INPUT(GPIOC_PIN9) |           \
                                     PIN_MODE_INPUT(GPIOC_PIN10) |          \
                                     PIN_MODE_INPUT(GPIOC_PIN11) |          \
                                     PIN_MODE_INPUT(GPIOC_PIN12) |          \
                                     PIN_MODE_INPUT(GPIOC_PIN13) |          \
                                     PIN_MODE_INPUT(GPIOC_OSC32_IN) |       \
                                     PIN_MODE_INPUT(GPIOC_OSC32_OUT))
#define VAL_GPIOC_OTYPER            (PIN_OTYPE_PUSHPULL(GPIOC_PIN0) |       \
                                     PIN_OTYPE_PUSHPULL(GPIOC_PIN1) |       \
                                     PIN_OTYPE_PUSHPULL(GPIOC_PIN2) |       \
                                     PIN_OTYPE_PUSHPULL(GPIOC_PIN3) |       \
                                     PIN_OTYPE_PUSHPULL(GPIOC_PIN4) |       \
                                     PIN_OTYPE_PUSHPULL(GPIOC_PIN5) |       \
                                     PIN_OTYPE_PUSHPULL(GPIOC_PIN6) |       \
                                     PIN_OTYPE_PUSHPULL(GPIOC_PIN7) |       \
                                     PIN_OTYPE_PUSHPULL(GPIOC_PIN8) |       \
                                     PIN_OTYPE_PUSHPULL(GPIOC_PIN9) |       \
                                     PIN_OTYPE_PUSHPULL(GPIOC_PIN10) |      \
                                     PIN_OTYPE_PUSHPULL(GPIOC_PIN11) |      \
                                     PIN_OTYPE_PUSHPULL(GPIOC_PIN12) |      \
                                     PIN_OTYPE_PUSHPULL(GPIOC_PIN13) |      \
                                     PIN_OTYPE_PUSHPULL(GPIOC_OSC32_IN) |   \
                                     PIN_OTYPE_PUSHPULL(GPIOC_OSC32_OUT))
#define VAL_GPIOC_OSPEEDR           (PIN_OSPEED_2M(GPIOC_PIN0) |            \
                                     PIN_OSPEED_2M(GPIOC_PIN1) |            \
                                     PIN_OSPEED_2M(GPIOC_PIN2) |            \
                                     PIN_OSPEED_2M(GPIOC_PIN3) |            \
                                     PIN_OSPEED_2M(GPIOC_PIN4) |            \
                                     PIN_OSPEED_2M(GPIOC_PIN5) |            \
                                     PIN_OSPEED_2M(GPIOC_PIN6) |            \
                                     PIN_OSPEED_2M(GPIOC_PIN7) |            \
                                     PIN_OSPEED_2M(GPIOC_PIN8) |            \
                                     PIN_OSPEED_2M(GPIOC_PIN9) |            \
                                     PIN_OSPEED_2M(GPIOC_PIN10) |           \
                                     PIN_OSPEED_2M(GPIOC_PIN11) |           \
                                     PIN_OSPEED_2M(GPIOC_PIN12) |           \
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
                                     PIN_AFIO_AF(GPIOE_PIN13, 0) |          \
                                     PIN_AFIO_AF(GPIOE_PIN14, 0) |          \
                                     PIN_AFIO_AF(GPIOE_PIN15, 0))

/*
 * GPIOF setup:
 *
 * PF0  - OSC_IN                    (input floating).
 * PF1  - OSC_OUT                   (input floating).
 * PF2  - PIN2                      (input pullup).
 * PF3  - PIN3                      (input pullup).
 * PF4  - PIN4                      (input pullup).
 * PF5  - PIN5                      (input pullup).
 * PF6  - PIN6                      (input pullup).
 * PF7  - PIN7                      (input pullup).
 * PF8  - PIN8                      (input pullup).
 * PF9  - PIN9                      (input pullup).
 * PF10 - PIN10                     (input pullup).
 * PF11 - PIN11                     (input pullup).
 * PF12 - PIN12                     (input pullup).
 * PF13 - PIN13                     (input pullup).
 * PF14 - PIN14                     (input pullup).
 * PF15 - PIN15                     (input pullup).
 */
#define VAL_GPIOF_MODER             (PIN_MODE_INPUT(GPIOF_OSC_IN) |         \
                                     PIN_MODE_INPUT(GPIOF_OSC_OUT) |        \
                                     PIN_MODE_INPUT(GPIOF_PIN2) |           \
                                     PIN_MODE_INPUT(GPIOF_PIN3) |           \
                                     PIN_MODE_INPUT(GPIOF_PIN4) |           \
                                     PIN_MODE_INPUT(GPIOF_PIN5) |           \
                                     PIN_MODE_INPUT(GPIOF_PIN6) |           \
                                     PIN_MODE_INPUT(GPIOF_PIN7) |           \
                                     PIN_MODE_INPUT(GPIOF_PIN8) |           \
                                     PIN_MODE_INPUT(GPIOF_PIN9) |           \
                                     PIN_MODE_INPUT(GPIOF_PIN10) |          \
                                     PIN_MODE_INPUT(GPIOF_PIN11) |          \
                                     PIN_MODE_INPUT(GPIOF_PIN12) |          \
                                     PIN_MODE_INPUT(GPIOF_PIN13) |          \
                                     PIN_MODE_INPUT(GPIOF_PIN14) |          \
                                     PIN_MODE_INPUT(GPIOF_PIN15))
#define VAL_GPIOF_OTYPER            (PIN_OTYPE_PUSHPULL(GPIOF_OSC_IN) |     \
                                     PIN_OTYPE_PUSHPULL(GPIOF_OSC_OUT) |    \
                                     PIN_OTYPE_PUSHPULL(GPIOF_PIN2) |       \
                                     PIN_OTYPE_PUSHPULL(GPIOF_PIN3) |       \
                                     PIN_OTYPE_PUSHPULL(GPIOF_PIN4) |       \
                                     PIN_OTYPE_PUSHPULL(GPIOF_PIN5) |       \
                                     PIN_OTYPE_PUSHPULL(GPIOF_PIN6) |       \
                                     PIN_OTYPE_PUSHPULL(GPIOF_PIN7) |       \
                                     PIN_OTYPE_PUSHPULL(GPIOF_PIN8) |       \
                                     PIN_OTYPE_PUSHPULL(GPIOF_PIN9) |       \
                                     PIN_OTYPE_PUSHPULL(GPIOF_PIN10) |      \
                                     PIN_OTYPE_PUSHPULL(GPIOF_PIN11) |      \
                                     PIN_OTYPE_PUSHPULL(GPIOF_PIN12) |      \
                                     PIN_OTYPE_PUSHPULL(GPIOF_PIN13) |      \
                                     PIN_OTYPE_PUSHPULL(GPIOF_PIN14) |      \
                                     PIN_OTYPE_PUSHPULL(GPIOF_PIN15))
#define VAL_GPIOF_OSPEEDR           (PIN_OSPEED_2M(GPIOF_OSC_IN) |          \
                                     PIN_OSPEED_2M(GPIOF_OSC_OUT) |         \
                                     PIN_OSPEED_2M(GPIOF_PIN2) |            \
                                     PIN_OSPEED_2M(GPIOF_PIN3) |            \
                                     PIN_OSPEED_2M(GPIOF_PIN4) |            \
                                     PIN_OSPEED_2M(GPIOF_PIN5) |            \
                                     PIN_OSPEED_2M(GPIOF_PIN6) |            \
                                     PIN_OSPEED_2M(GPIOF_PIN7) |            \
                                     PIN_OSPEED_2M(GPIOF_PIN8) |            \
                                     PIN_OSPEED_2M(GPIOF_PIN9) |            \
                                     PIN_OSPEED_2M(GPIOF_PIN10) |           \
                                     PIN_OSPEED_2M(GPIOF_PIN11) |           \
                                     PIN_OSPEED_2M(GPIOF_PIN12) |           \
                                     PIN_OSPEED_2M(GPIOF_PIN13) |           \
                                     PIN_OSPEED_2M(GPIOF_PIN14) |           \
                                     PIN_OSPEED_2M(GPIOF_PIN15))
#define VAL_GPIOF_PUPDR             (PIN_PUPDR_FLOATING(GPIOF_OSC_IN) |     \
                                     PIN_PUPDR_FLOATING(GPIOF_OSC_OUT) |    \
                                     PIN_PUPDR_PULLUP(GPIOF_PIN2) |         \
                                     PIN_PUPDR_PULLUP(GPIOF_PIN3) |         \
                                     PIN_PUPDR_PULLUP(GPIOF_PIN4) |         \
                                     PIN_PUPDR_PULLUP(GPIOF_PIN5) |         \
                                     PIN_PUPDR_PULLUP(GPIOF_PIN6) |         \
                                     PIN_PUPDR_PULLUP(GPIOF_PIN7) |         \
                                     PIN_PUPDR_PULLUP(GPIOF_PIN8) |         \
                                     PIN_PUPDR_PULLUP(GPIOF_PIN9) |         \
                                     PIN_PUPDR_PULLUP(GPIOF_PIN10) |        \
                                     PIN_PUPDR_PULLUP(GPIOF_PIN11) |        \
                                     PIN_PUPDR_PULLUP(GPIOF_PIN12) |        \
                                     PIN_PUPDR_PULLUP(GPIOF_PIN13) |        \
                                     PIN_PUPDR_PULLUP(GPIOF_PIN14) |        \
                                     PIN_PUPDR_PULLUP(GPIOF_PIN15))
#define VAL_GPIOF_ODR               (PIN_ODR_HIGH(GPIOF_OSC_IN) |           \
                                     PIN_ODR_HIGH(GPIOF_OSC_OUT) |          \
                                     PIN_ODR_HIGH(GPIOF_PIN2) |             \
                                     PIN_ODR_HIGH(GPIOF_PIN3) |             \
                                     PIN_ODR_HIGH(GPIOF_PIN4) |             \
                                     PIN_ODR_HIGH(GPIOF_PIN5) |             \
                                     PIN_ODR_HIGH(GPIOF_PIN6) |             \
                                     PIN_ODR_HIGH(GPIOF_PIN7) |             \
                                     PIN_ODR_HIGH(GPIOF_PIN8) |             \
                                     PIN_ODR_HIGH(GPIOF_PIN9) |             \
                                     PIN_ODR_HIGH(GPIOF_PIN10) |            \
                                     PIN_ODR_HIGH(GPIOF_PIN11) |            \
                                     PIN_ODR_HIGH(GPIOF_PIN12) |            \
                                     PIN_ODR_HIGH(GPIOF_PIN13) |            \
                                     PIN_ODR_HIGH(GPIOF_PIN14) |            \
                                     PIN_ODR_HIGH(GPIOF_PIN15))
#define VAL_GPIOF_AFRL              (PIN_AFIO_AF(GPIOF_OSC_IN, 0) |         \
                                     PIN_AFIO_AF(GPIOF_OSC_OUT, 0) |        \
                                     PIN_AFIO_AF(GPIOF_PIN2, 0) |           \
                                     PIN_AFIO_AF(GPIOF_PIN3, 0) |           \
                                     PIN_AFIO_AF(GPIOF_PIN4, 0) |           \
                                     PIN_AFIO_AF(GPIOF_PIN5, 0) |           \
                                     PIN_AFIO_AF(GPIOF_PIN6, 0) |           \
                                     PIN_AFIO_AF(GPIOF_PIN7, 0))
#define VAL_GPIOF_AFRH              (PIN_AFIO_AF(GPIOF_PIN8, 0) |           \
                                     PIN_AFIO_AF(GPIOF_PIN9, 0) |           \
                                     PIN_AFIO_AF(GPIOF_PIN10, 0) |          \
                                     PIN_AFIO_AF(GPIOF_PIN11, 0) |          \
                                     PIN_AFIO_AF(GPIOF_PIN12, 0) |          \
                                     PIN_AFIO_AF(GPIOF_PIN13, 0) |          \
                                     PIN_AFIO_AF(GPIOF_PIN14, 0) |          \
                                     PIN_AFIO_AF(GPIOF_PIN15, 0))


#if !defined(_FROM_ASM_)
#ifdef __cplusplus
extern "C" {
#endif
  void boardInit(void);
#ifdef __cplusplus
}
#endif
#endif /* _FROM_ASM_ */

#endif /* _BOARD_H_ */
