adamgreig/supervide/firmware/drivers/oled.c

#include "drivers/oled.h"
#include <ch.h>
#include <hal.h>
#include <string.h>
#include "drivers/dma_mutexes.h"

#define OLED_SPID     SPID1
#define OLED_RST_PORT GPIOB
#define OLED_RST_PIN  GPIOB_OLED_RST
#define OLED_DC_PORT  GPIOA
#define OLED_DC_PIN   GPIOA_OLED_DC
#define OLED_CS_PORT  GPIOB
#define OLED_CS_PIN   GPIOB_OLED_CS

uint8_t oled_buffer[4][128];

static void oled_start(void);
static void oled_stop(void);

static uint8_t oled_init_cmds[] = {
    0xAE,       /* OLED panel off */
    0xD5, 0x70, /* Display clock divide: default freq, div by 1 */
    0xA8, 0x1F, /* MUX ratio: 32MUX (as 32 rows) */
    0xD3, 0x00, /* Display offset: not offset */
    0xD8, 0x05, /* Area Colour Mode: monochrome, low power mode */
    0xA1,       /* Segment remap: Remap columns, flipping left/right */
    0xC8,       /* COM scan direction: Flipped top/bottom */
    0xDA, 0x12, /* COM pins hardware config: L/R remap + alt config */
    0x91, 0x3F, 0x3F, 0x3F, 0x3F, /* Current drive pulse widths */
    0xD9, 0x22, /* Pre-charge period: default values (example is 0xD2) */
    0xDB, 0x34, /* VCOMH: 0.77 * VCC (default) */
    0xA6,       /* Normal (not inverse) display */
    0xA4,       /* Disable entire display ON */
    0x20, 0x00, /* Memory addressing mode: horizontal */
    0x21, 4, 131, /* Start at column 4, end at column 131 (NB 0xA1 remap) */
    0x22, 0x00, 0x03, /* Start page 0, end at page 3 (as 4 rows of 8 pix) */
    0x81, 0xFF, /* Contrast control: maximum contrast */
    0x82, 0xFF, /* Set maximum brightness for colour banks */
    0xAD, 0x8F, /* Master configuration: DC-DC enabled */
    0xAF,       /* OLED panel on, normal (not dim) mode */
};

static uint8_t oled_sv_logo[4][128] = {
    { 0xFF, 0x01, 0x01, 0x01, 0x01, 0x01, 0x01, 0x01, 0x01, 0x01, 0x01, 0x01,
0x01, 0x01, 0x01, 0x01, 0x01, 0x01, 0x01, 0x01, 0x01, 0x01, 0x01, 0x01, 0x01,
0x01, 0x01, 0x01, 0x01, 0x01, 0x01, 0x01, 0x01, 0x01, 0x01, 0x01, 0x01, 0x01,
0x01, 0x01, 0x01, 0x01, 0x01, 0x01, 0x01, 0x01, 0x01, 0x01, 0x01, 0x01, 0x01,
0x01, 0x01, 0x01, 0x01, 0x01, 0x01, 0x01, 0x01, 0x01, 0x01, 0x01, 0x01, 0x01,
0x01, 0x01, 0x01, 0x01, 0x01, 0x01, 0x01, 0x01, 0x01, 0x01, 0x01, 0x01, 0x01,
0x01, 0x01, 0x01, 0x01, 0x01, 0x01, 0x01, 0x01, 0x01, 0x01, 0x01, 0x01, 0x01,
0x01, 0x01, 0x01, 0x01, 0x01, 0x01, 0x01, 0x01, 0x01, 0x01, 0x01, 0x01, 0x01,
0x01, 0x01, 0x01, 0x01, 0x01, 0x01, 0x01, 0x01, 0x01, 0x01, 0x01, 0x01, 0x01,
0x01, 0x01, 0x01, 0x01, 0x01, 0x01, 0x01, 0x01, 0x01, 0x01, 0x01, 0xFF     },
    { 0xFF, 0x00, 0x7C, 0xFE, 0xFE, 0xFF, 0xE7, 0xC3, 0xC3, 0xC3, 0xC3, 0x87,
0x8F, 0x00, 0x00, 0x00, 0x00, 0xFF, 0xFF, 0xFF, 0xFF, 0x00, 0x00, 0x00, 0x00,
0x00, 0xFF, 0xFF, 0xFF, 0xFF, 0x00, 0x00, 0x00, 0xFF, 0xFF, 0xFF, 0xFF, 0x03,
0x03, 0x03, 0x87, 0xFF, 0xFE, 0xFE, 0x78, 0x00, 0x00, 0x00, 0xFF, 0xFF, 0xFF,
0xFF, 0xC3, 0xC3, 0xC3, 0xC3, 0xC3, 0x03, 0x00, 0x00, 0x00, 0x00, 0xFF, 0xFF,
0xFF, 0xFF, 0x83, 0x83, 0x83, 0xFF, 0xFF, 0x7E, 0x3C, 0x00, 0x00, 0x01, 0x0F,
0x7F, 0xFF, 0xFE, 0xF0, 0x80, 0x00, 0x80, 0xF0, 0xFE, 0xFF, 0x7F, 0x0F, 0x01,
0x00, 0x00, 0xFF, 0xFF, 0xFF, 0xFF, 0x00, 0x00, 0x00, 0xFF, 0xFF, 0xFF, 0xFF,
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
            for(x=0; x<40; x++)
                oled_buffer[3-y][x+88] = 0;
    else
        for(y=0; y<4; y++)
            for(x=0; x<40; x++)
                oled_buffer[3-y][x+88] = *(icon + y*40 + x);
}

void oled_erase() {
    memset(oled_buffer, 0, sizeof(oled_buffer));
}

void oled_text_small(uint8_t line, uint8_t x, const char* str)
{
    int i, j;
    int len = strnlen(str, 21-x);
    
    if(line > 3)
        line = 0;

    if(x > 20)
        x = 0;

    for(i=0; i<len; i++) {
        char c = str[i];
        if(c < ' ' || c > '~')
            c = 0;
        else
            c -= ' ';
        
        for(j=0; j<6; j++) {
            oled_buffer[line][1+(x+i)*6+j] = oled_font[(int)c][j];
        }
    }
}

void oled_text_big(uint8_t line, uint8_t x, const char* str)
{
    int i, j;
    int len = strnlen(str, 10-x);
    
    if(line > 1)
        line = 0;

    if(x > 9)
        x = 0;

    for(i=0; i<len; i++) {
        char c = str[i];
        if(c < ' ' || c > '~')
            c = 0;
        else
            c -= ' ';

        for(j=0; j<6; j++) {
            oled_buffer[line*2+0][1+(x+i)*12+j*2+0] =
                oled_nibble_stretch[oled_font[(int)c][j] & 0x0F];
            oled_buffer[line*2+0][1+(x+i)*12+j*2+1] =
                oled_nibble_stretch[oled_font[(int)c][j] & 0x0F];
            oled_buffer[line*2+1][1+(x+i)*12+j*2+0] =
                oled_nibble_stretch[oled_font[(int)c][j] >> 4];
            oled_buffer[line*2+1][1+(x+i)*12+j*2+1] =
                oled_nibble_stretch[oled_font[(int)c][j] >> 4];
        }
    }
}

void oled_draw()
{
    oled_start();

    /* Write the buffer to the OLED */
    palClearPad(OLED_DC_PORT, OLED_DC_PIN);
    palSetPad(OLED_DC_PORT, OLED_DC_PIN);
    spiSelect(&OLED_SPID);
    spiSend(&OLED_SPID, sizeof(oled_buffer), (void*)oled_buffer);
    spiUnselect(&OLED_SPID);

    oled_stop();
}
