adamgreig/supervide/(commit log)

2015-02-03 first go at control board schematic
    [control.sch]
2015-02-14 update sch: new oled, sync conditioning
    [control.sch]
2015-02-15 update sch: connection to power board
    [control.sch]
2015-02-18 Initial sketch of power schematic
    [power.sch]
2015-02-20 Removed PGA+RMS, added preheat relay
    [power.sch]
2015-02-21 SPST relays, filled in many values
    [power.sch]
2015-02-21 P sch: up2date connector, dbl winding xformer
    [power.sch]
2015-02-22 P sch: filled in most component part #s
    [power.sch]
2015-02-23 P sch: switcher PSU + tiny xover sense xformer
    [power.sch]
2015-02-24 Power: added TODO
2015-02-28 further work on control, start routing pcb
    [control.kicad_pcb, control.sch]
2015-02-28 Psch: crossover MOC, ds18b20, ERC
    * Changed MOC chip to one with builtin crossover, removed crossover sensing
    circuit.
    * Added DS18B20 temperature sensor (intended for mounting to the triac
    heatsink) on the pin previously used for crossover sense.
    * Minor changes around the PSU area to make ERC pass.
    [power.sch]
2015-03-01 Power footprints and associations
    Also first thoughts on PCB shape and connector placement
    [power.kicad_pcb, power.sch]
2015-03-02 Power: onboard fuses, better attempt at first pcb
    [power.kicad_pcb, power.sch]
2015-03-02 Removed neutral switching, more pcb mains rev
    [power.kicad_pcb, power.sch]
2015-03-03 Power: Thermal switch based cutoff
    [power.kicad_pcb, power.sch]
2015-03-04 first routing complete!
    [control.kicad_pcb, control.sch]
2015-03-04 some routing improvements
    [control.kicad_pcb, control.sch]
2015-03-04 Updated TRIAC part, added LEDs.
    [power.kicad_pcb, power.sch]
2015-03-04 P: Updated connector footprint and pinout
    Also decided to stick with ACS712 instead of cheaper/smaller ACS710 because the
    former is SOICW instead of SOIC so has a bit more isolation distance.
    [power.kicad_pcb, power.sch]
2015-03-05 Ppcb: first full route attempt
    [power.kicad_pcb]
2015-03-06 update wifi, routing, gen gerbers, DONE r1
    [control-B_Cu.gbl, control-B_Mask.gbs, control-B_Paste.gbp, control-B_SilkS.gbo, control-Edge_Cuts.gbr, control-F_Cu.gtl, control-F_Mask.gts, control-F_Paste.gtp]
2015-03-06 fix a few derps, actually DONE r1
    [control-B_Cu.gbl, control-B_Mask.gbs, control-B_Paste.gbp, control-B_SilkS.gbo, control-Edge_Cuts.gbr, control-F_Cu.gtl, control-F_Mask.gts, control-F_Paste.gtp]
2015-03-06 Ppcb: triac heatsink and reroutes
    [power.kicad_pcb]
2015-03-06 Ppcb: Gerbil export settings
    [power.kicad_pcb]
2015-03-11 shift coin cell a little to make more space. still r1.
    [control-B_Cu.gbl, control-B_Mask.gbs, control-B_Paste.gbp, control-B_SilkS.gbo, control-Edge_Cuts.gbr, control-F_Cu.gtl, control-F_Mask.gts, control-F_Paste.gtp]
2015-03-28 Added *correct* heatsink to schematic.
    [power.kicad_pcb, power.sch]
2015-03-29 Mostly LED value fixes, relay transistors
    [power.sch]
2015-03-29 Lots of footprint modifications
    [power.kicad_pcb, power.sch]
2015-03-30 Test points, rerouted relay drivers.
    [power.kicad_pcb, power.sch]
2015-03-30 regen gerbils w/ correct date on silk
    [control-B_Cu.gbl, control-B_Mask.gbs, control-B_Paste.gbp, control-B_SilkS.gbo, control-Edge_Cuts.gbr, control-F_Cu.gtl, control-F_Mask.gts, control-F_Paste.gtp]
2015-03-30 Silk, cleanup, masking, gerbils
    [power-B_Cu.gbl, power-B_Mask.gbs, power-B_SilkS.gbo, power-Edge_Cuts.gbr, power-F_Cu.gtl, power-F_Mask.gts, power-F_SilkS.gto, power.drl]
2015-04-09 Power board BOM
    [bom.ods]
2015-04-10 Added fuses to power BOM
    [bom.ods]
2015-04-10 BOMs and gerbers
2015-04-20 mounting h/w for power board
    [mounting hardware.ods]
2015-05-02 Firmware setup README and basic powerboard C drivers
2015-05-02 ChibiOS support lib, basic power driver
2015-07-06 PWM wrappers and TRIAC control driver
2015-07-06 Basic ADC driver and current conversion routine
2015-07-28 Power: Added relay flyback diodes. Fixes #10
    [power.kicad_pcb, power.sch]
2015-09-07 Power: Triac pin spacing, removed extra relay pads
    Resolves #3
    [power.kicad_pcb]
2015-10-04 Flipped SOT23 footprint. Fixes #1
    [power.kicad_pcb]
2015-10-04 Bumped thermal switch drills. Fixes #2
    [power.kicad_pcb]
2015-10-04 Added voltage warning, bumped rev+date
    Resolves #23 and resolves #6
    [power.kicad_pcb]
2015-10-04 add resistor to red LED, closes #4
    [control.kicad_pcb, control.sch]
2015-10-04 add strain relief for tc, closes #5
    [control.kicad_pcb]
2015-10-04 add ldo for wifi, closes #7 probably
    [control.kicad_pcb, control.sch]
2015-10-04 update coin cell silk, closes #8
    [control.kicad_pcb]
2015-10-04 Removed all traces of rust, untested C power driver
2015-10-04 smaller 32k xtal, closes #21
    [control.kicad_pcb, control.sch]
2015-10-04 add LEDs to control, closes #22
    [control.kicad_pcb, control.sch]
2015-10-04 add more resistors to rot end LEDs
    [control.kicad_pcb, control.sch]
2015-10-04 add tagconnect TC2030-CTX-NL footprint
    [control.kicad_pcb, control.sch]
2015-10-07 rework buzzer driver to use non-inverting amplifiers
    [control.kicad_pcb, control.sch]
2015-10-07 move via slightly
    [control.kicad_pcb]
2015-10-07 plot new gerbers
    [control-B_Cu.gbl, control-B_Mask.gbs, control-B_Paste.gbp, control-B_SilkS.gbo, control-Edge_Cuts.gbr, control-F_Cu.gtl, control-F_Mask.gts, control-F_Paste.gtp]
2015-10-07 swap to GPT2 for DAC timer
    [main.c]
2015-10-07 Many minor fixes, resolves #25
    [power-B_Cu.gbl, power-B_Mask.gbs, power-B_SilkS.gbo, power-Edge_Cuts.gbr, power-F_Cu.gtl, power-F_Mask.gts, power-F_SilkS.gto, power.drl]
2015-10-07 Updated gerber zip
2015-10-07 basic encoder stuff working
2015-10-07 add basic encoder switch support
2015-10-22 bom update
    [control.sch]
2015-10-23 Added power board BOM
2015-10-24 Added STM32F0-specific ADC conv grp settings
2015-10-24 first go at oled driver
2015-10-24 longer wait for oled to reset
    [oled.c]
2015-10-24 Working TRIAC+relay driver and demo
2015-10-24 Used MS2ST for triac pwm timing.
    Resolves #27
    [powerboard.c]
2015-10-24 Removed missing ADC config register
    [powerboard.c]
2015-10-24 small fix to oled driver to quash warning
    [oled.c]
2015-10-25 rotenc driver sort of thing
2015-10-25 disable LSE while one board still lacks it
2015-10-25 fix piezo dma business
    [piezo.c]
2015-11-01 Fixed R9 part number. Fixes #26
    [power.sch]
2016-03-18 update thermo driver to convert to 0.1 C
2016-03-18 Changed cook update timer to 200ms b/c aliasing
2016-03-18 fix returning from display thermo menu screen
    [clock.c, menu.c, thermo.c]
2016-03-18 Remove power debug from main()
2016-03-18 fix temp display in custom input
    [menu.c]
2016-03-19 add live temperature plotting
2016-03-19 read and compensate for actual VREF voltage
2016-03-19 implement moving average filter and update liveplot to handle it
2016-04-05 First prototype of laser cuts
    [control.dxf, plate.dxf, power.dxf, power_mounting_plate.dxf, power_mounting_plate_small.dxf]
2016-04-06 Shortened end plates. FIxes #29
    [control.dxf, plate.dxf, power.dxf]
2016-04-06 Moved around IEC holes. Fixes #32, fixes #30
    [power.dxf]
2016-04-06 Shortened power mounting plate. fixes #31
    [power_mounting_plate.dxf]
